LeechCSE/Arduino-path-following-car/README.md

Arduino: path-following-car
=====
EE 3: Introduction to Electrical Engineering  
Fall 2017
